ponton5900/AM_radio_circuit_project/(commit log)

2025-08-29 Update README.md (Update circuit_diagram)
2025-08-29 Add circuit_diagram's picture
2025-08-29 Add a circuit_diagram's picture
2025-08-29 Update README.md(Update circuit_diagram's picture)
